menduhkesici/Wireless-Fire-Detection-System/Project Photo.JPG

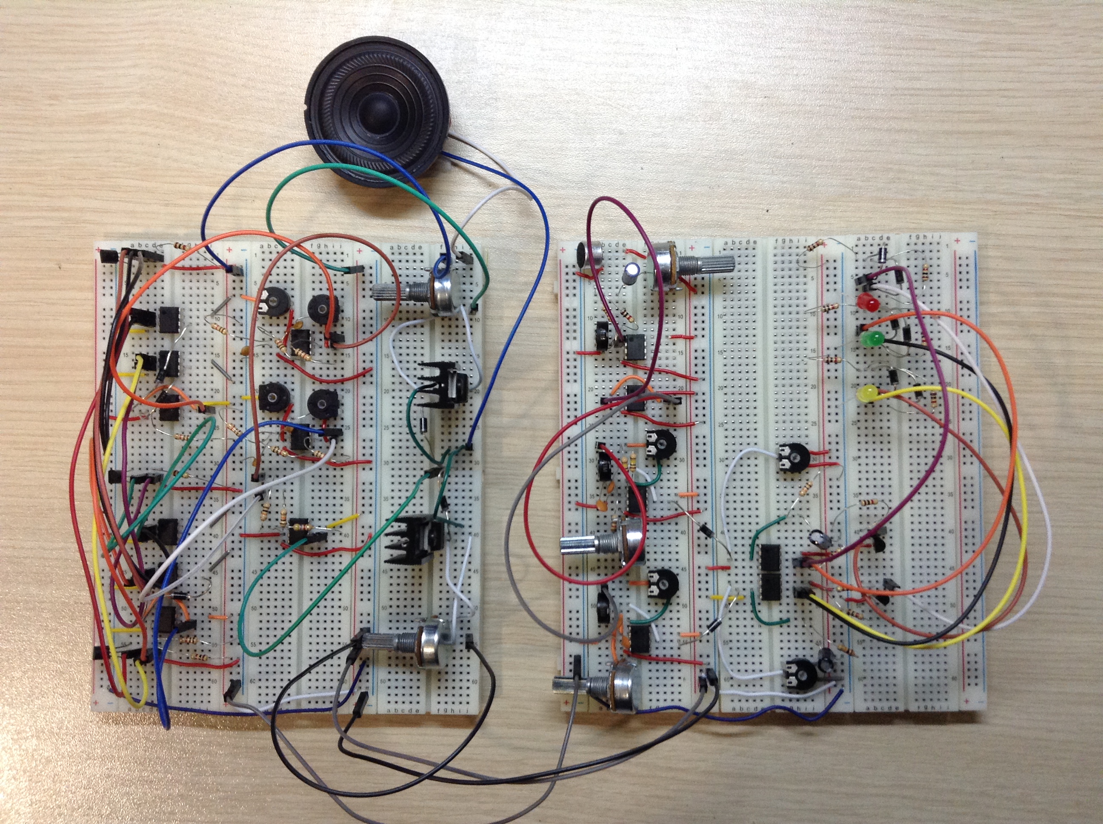
Project Photo.JPG
