menduhkesici/Wireless-Fire-Detection-System/README.md

# Wireless Fire Detection System

The report, schematic and photo of the term project "Wireless Fire Detection System".
