menduhkesici/Wireless-Fire-Detection-System/Project Schematic.asc

C5: cap; 1n
C6: cap; 1n
C7: cap; 1n
C8: cap; 1n
C9: cap; 10n
C10: cap; 1µ
C11: cap; 10n
C12: cap; 1µ
C13: cap; 10n
C14: cap; 10n
C17: cap; 1µ
D1: diode
D2: diode
D3: diode
D4: diode
D7: diode
D8: diode
D10: diode
D11: diode
D12: diode
D13: diode
D14: diode
D15: diode
D29: diode
D30: diode
LM35_1: res
LM35_2: res
LM35_3: res
Microphone: voltage
Q4: npn
Q5: npn
Q12: pnp; BC557C
Q13: npn; BC547C
R9: res; 1k
R10: res; 1k
R11: res; 1k
R12: res; 1k
R13: res; 1k
R14: res; 1k
R15: res; 1k
R16: res; 500
R17: res; 1m_POT
R18: res; 2.7k
R19: res; 1k
R20: res; 10k
R21: res; 10k
R22: res; 5k
R23: res; 1100k
R24: res; 180k
R25: res; 620k
R26: res; 110k
R27: res; 50k_POT
R28: res; 1.6k
R29: res; 10k
R30: res; 1k
R31: res; 1k
R32: res; 1k
R33: res; 5k
R34: res; 1k
R35: res; 1k
R36: res; 1k
R37: res; 1k
R38: res; 1k
R39: res; 1k
R40: res; 5.3k
R41: res; 5.3k
R42: res; 10k
R43: res; 5k
R44: res; 3.2k
R45: res; 3.2k
R49: res; 560
R50: res; 560
R51: res; 50
U3: UniversalOpamp2
U4: UniversalOpamp2
U5: UniversalOpamp2
U6: UniversalOpamp2
U7: UniversalOpamp2
U8: UniversalOpamp2
U9: UniversalOpamp2
U10: UniversalOpamp2
U11: UniversalOpamp2
U12: UniversalOpamp2
U13: UniversalOpamp2
U14: UniversalOpamp2
U15: UniversalOpamp2
U16: UniversalOpamp2
V1: voltage; 12
V2: voltage; 12
Named nets: 0, +12V, V_1, V_2, V_3, -12V, Input_1, Sine_1, Sine_2, Speaker_Input, Microphone_Output, Input_2, Output_1, Output_2, Red_LED, Output_1_Rectified, Output_2_Rectified, +5V, A, B, Green_LED, A_not, B_not, Blue_LED, Input_1_Buffered, Input_2_Buffered
Filter for 3kHz
Filter for 5kHz
Sine Wave Generotor for 3kHz
Sine Wave Generotor for 5kHz
